Makers-Oakland-University/Makers-Unified-Controller/README.md

# Makers Unified Controller

The Makers at OU unified controller is a simple controller based on the ESP32 designed to be a one-size fits all controller for robotics projects and interactive exhibits. 
It is designed to be low cost, simple to assemble, and versatile to suit any project requirements. 
Programming and charging are accomplished by the available micro-usb plug, the battery can also be changed by the user. 

## Contents
This repo contains the EDA and CAD files for the controller created with [KiCad](https://www.kicad.org/) and [FreeCAD](https://www.freecadweb.org/) respectively. 
Both tools are open source and freely available 

## Contributing
For any new changes to the controller after version 1 please create a branch of pull request for any major design changes to the controller. 

## License
[MIT](https://choosealicense.com/licenses/mit/)
