Makers-Oakland-University/Makers-Unified-Controller/Controller Case/Makers-Unified-Controller-Rev1-Case.FCStd

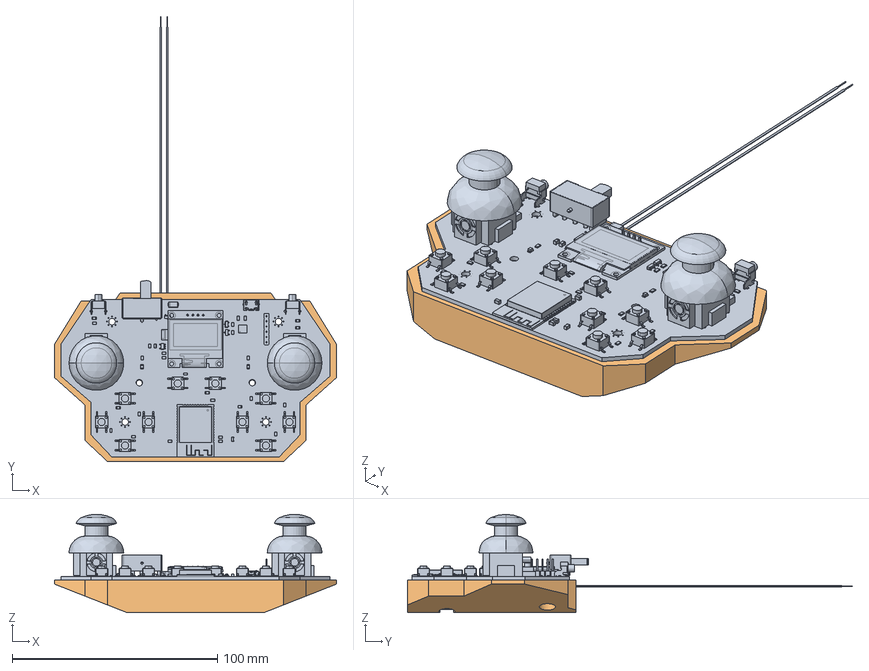
[picture p1: CAD file, 2021-12-16]
Controller Case/Makers-Unified-Controller-Rev1-Case.FCStd
137.4 x 216.7 x 47.9 mm
Makers-Unified-Controller
Bottom
