Makers-Oakland-University/Makers-Unified-Controller/Makers-Unified-Controller/Imports/PRT-18286.step

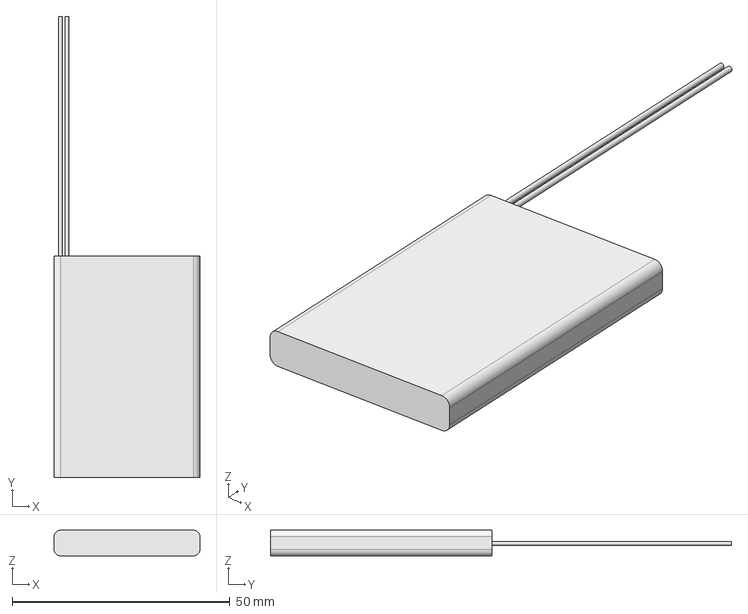
[picture p2: CAD file, 2022-06-18]
Makers-Unified-Controller/Imports/PRT-18286.step
33.5 x 105.8 x 5.90 mm
