Makers-Oakland-University/Makers-Unified-Controller/Makers-Unified-Controller/Imports/IND_NRS5024T4R7MMGJ_TAY.step

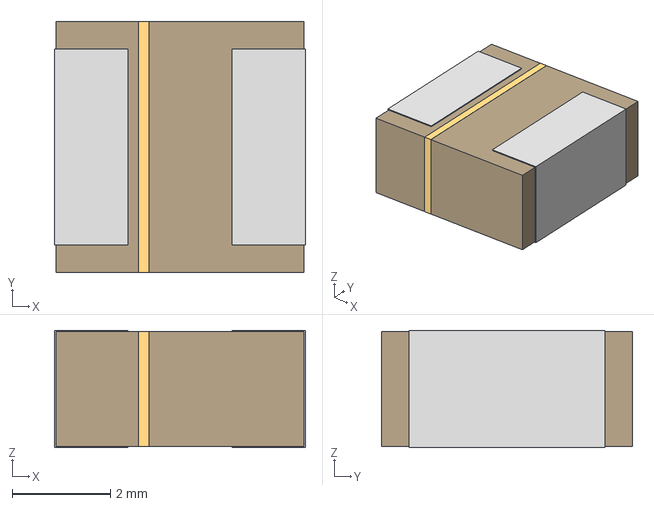
[picture p3: CAD file, 2021-12-05]
Makers-Unified-Controller/Imports/IND_NRS5024T4R7MMGJ_TAY.step
5.11 x 5.11 x 2.39 mm
