Makers-Oakland-University/Makers-Unified-Controller/Makers-Unified-Controller/Imports/c-1825027-8-g-3d.stp

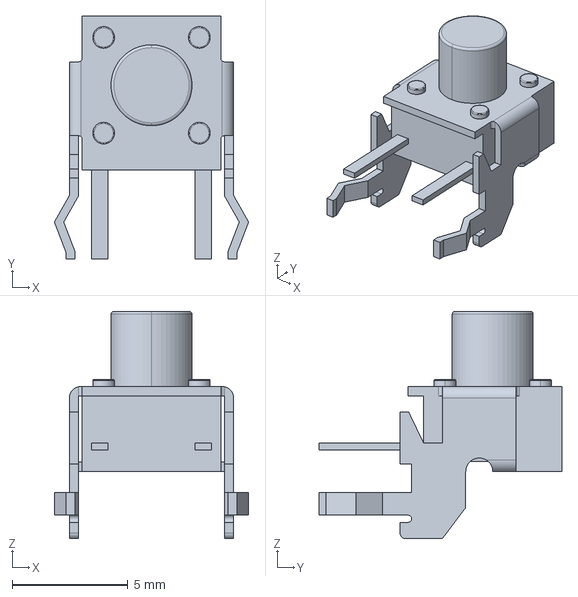
[picture p4: CAD file, 2021-12-05]
Makers-Unified-Controller/Imports/c-1825027-8-g-3d.stp
8.41 x 10.5 x 9.84 mm
