Makers-Oakland-University/Makers-Unified-Controller/Makers-Unified-Controller/Imports/USB4105--3DModel-STEP-56544.STEP

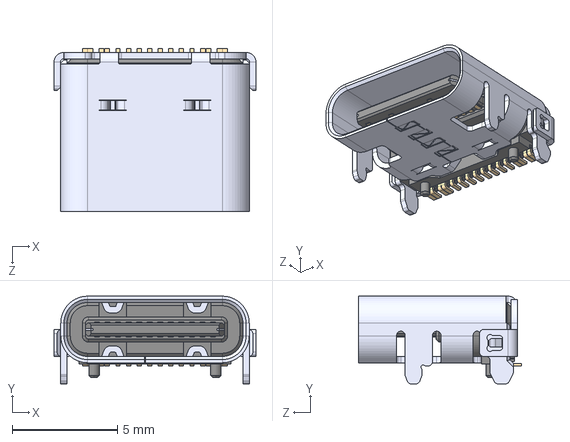
[picture p5: CAD file, 2021-12-05]
Makers-Unified-Controller/Imports/USB4105--3DModel-STEP-56544.STEP
9.58 x 4.16 x 7.71 mm
