Makers-Oakland-University/Makers-Unified-Controller/Makers-Unified-Controller/Imports/BC4AAW.step

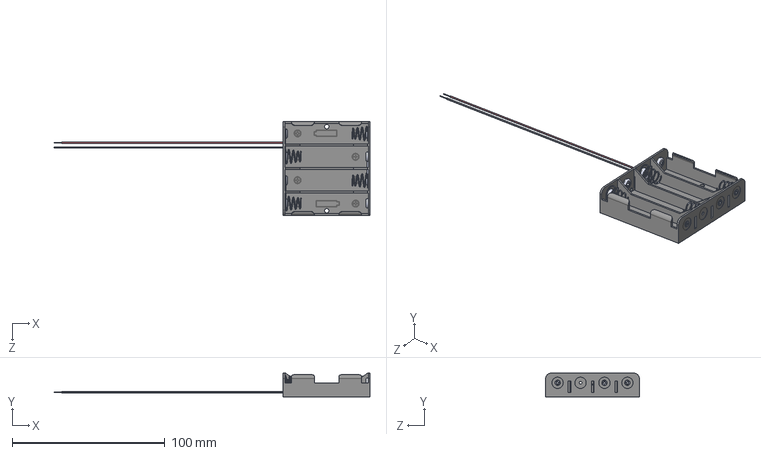
[picture p6: CAD file, 2021-12-05]
Makers-Unified-Controller/Imports/BC4AAW.step
206.8 x 15.5 x 61.3 mm
