Makers-Oakland-University/Makers-Unified-Controller/Makers-Unified-Controller/Imports/c-1571563-4-v-3d.stp

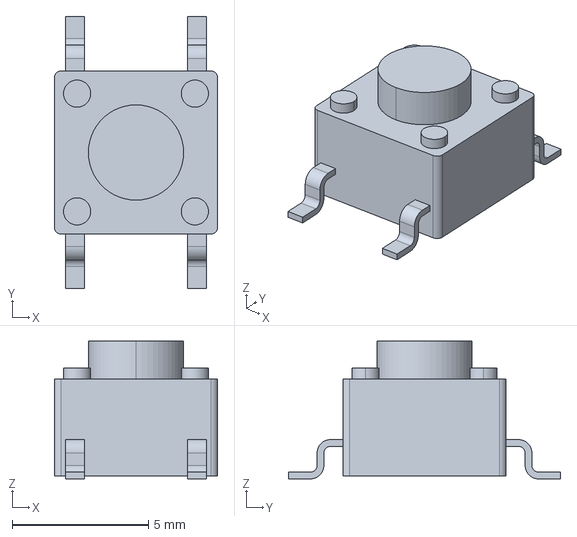
[picture p7: CAD file, 2021-12-05]
Makers-Unified-Controller/Imports/c-1571563-4-v-3d.stp
6.00 x 10.0 x 5.07 mm
