Makers-Oakland-University/Makers-Unified-Controller/Makers-Unified-Controller/Imports/SSD1306.STP

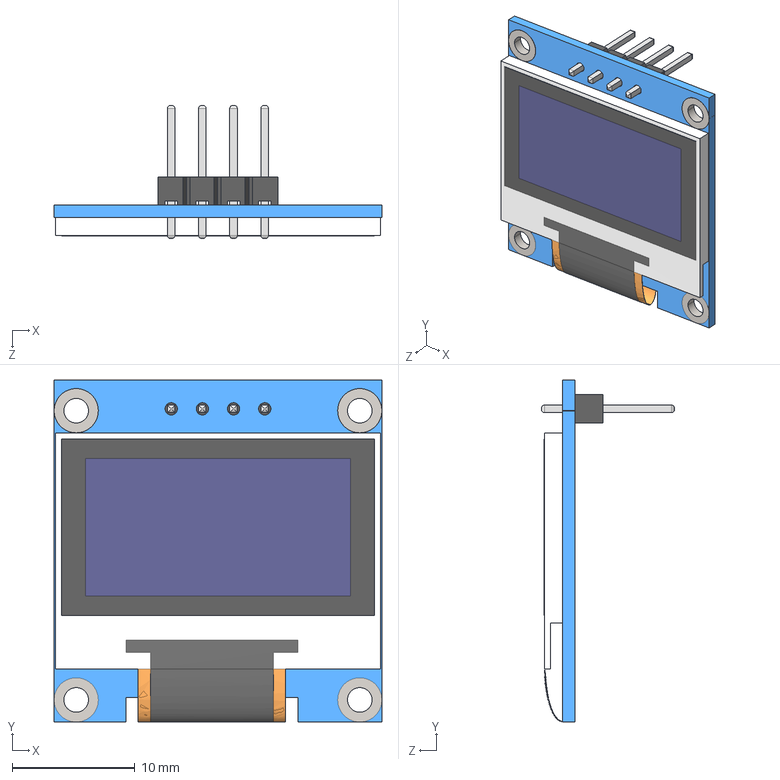
[picture p8: CAD file, 2021-12-05]
Makers-Unified-Controller/Imports/SSD1306.STP
26.7 x 27.9 x 10.8 mm
