Makers-Oakland-University/Makers-Unified-Controller/Makers-Unified-Controller/Imports/COM-09032.step

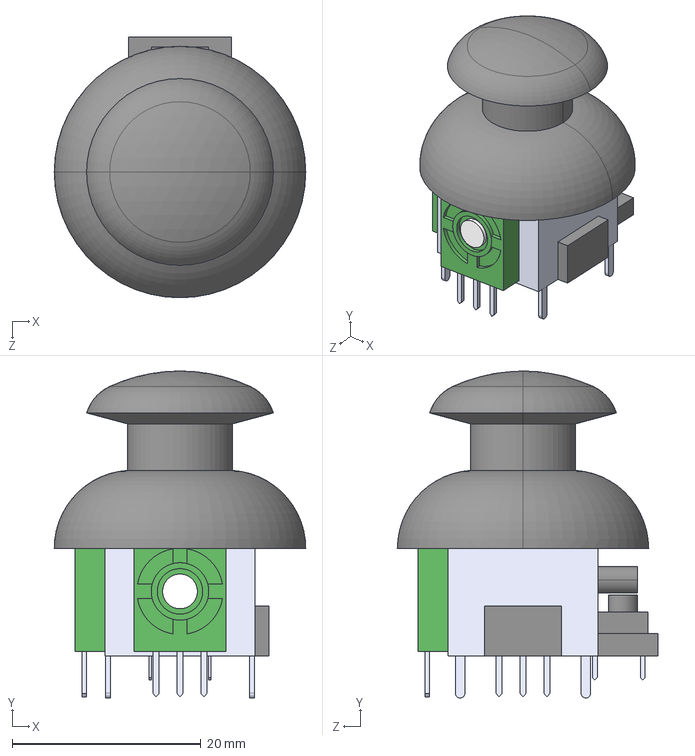
[picture p9: CAD file, 2021-12-05]
Makers-Unified-Controller/Imports/COM-09032.step
26.7 x 34.7 x 27.6 mm
