Makers-Oakland-University/Makers-Unified-Controller/Makers-Unified-Controller/Imports/10118192-0002LF.step

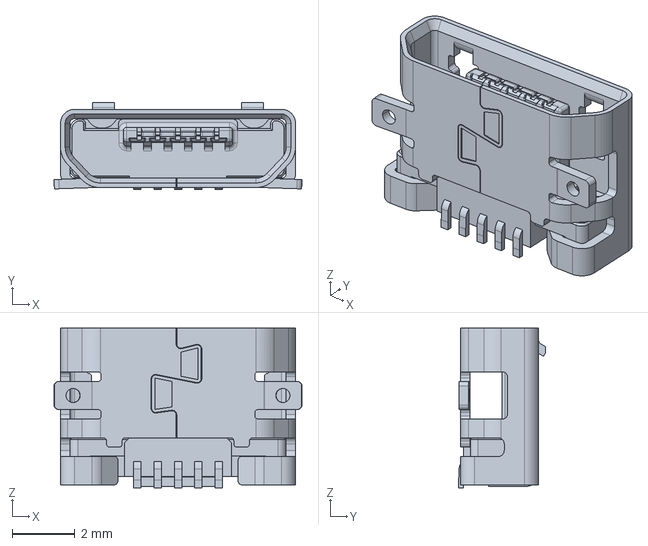
[picture p10: CAD file, 2021-12-05]
Makers-Unified-Controller/Imports/10118192-0002LF.step
7.91 x 2.77 x 5.10 mm
