Makers-Oakland-University/Makers-Unified-Controller/Makers-Unified-Controller/Imports/L102021ML04Q.step

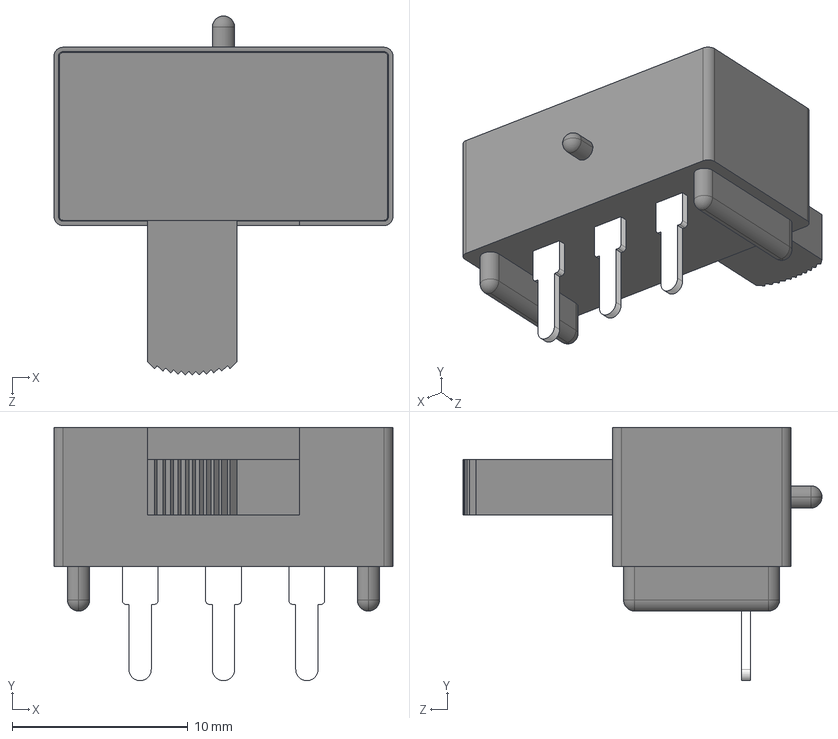
[picture p11: CAD file, 2021-12-05]
Makers-Unified-Controller/Imports/L102021ML04Q.step
19.3 x 14.4 x 20.4 mm
