Makers-Oakland-University/Makers-Unified-Controller/Makers-Unified-Controller/Makers-Unified-Controller.pdf

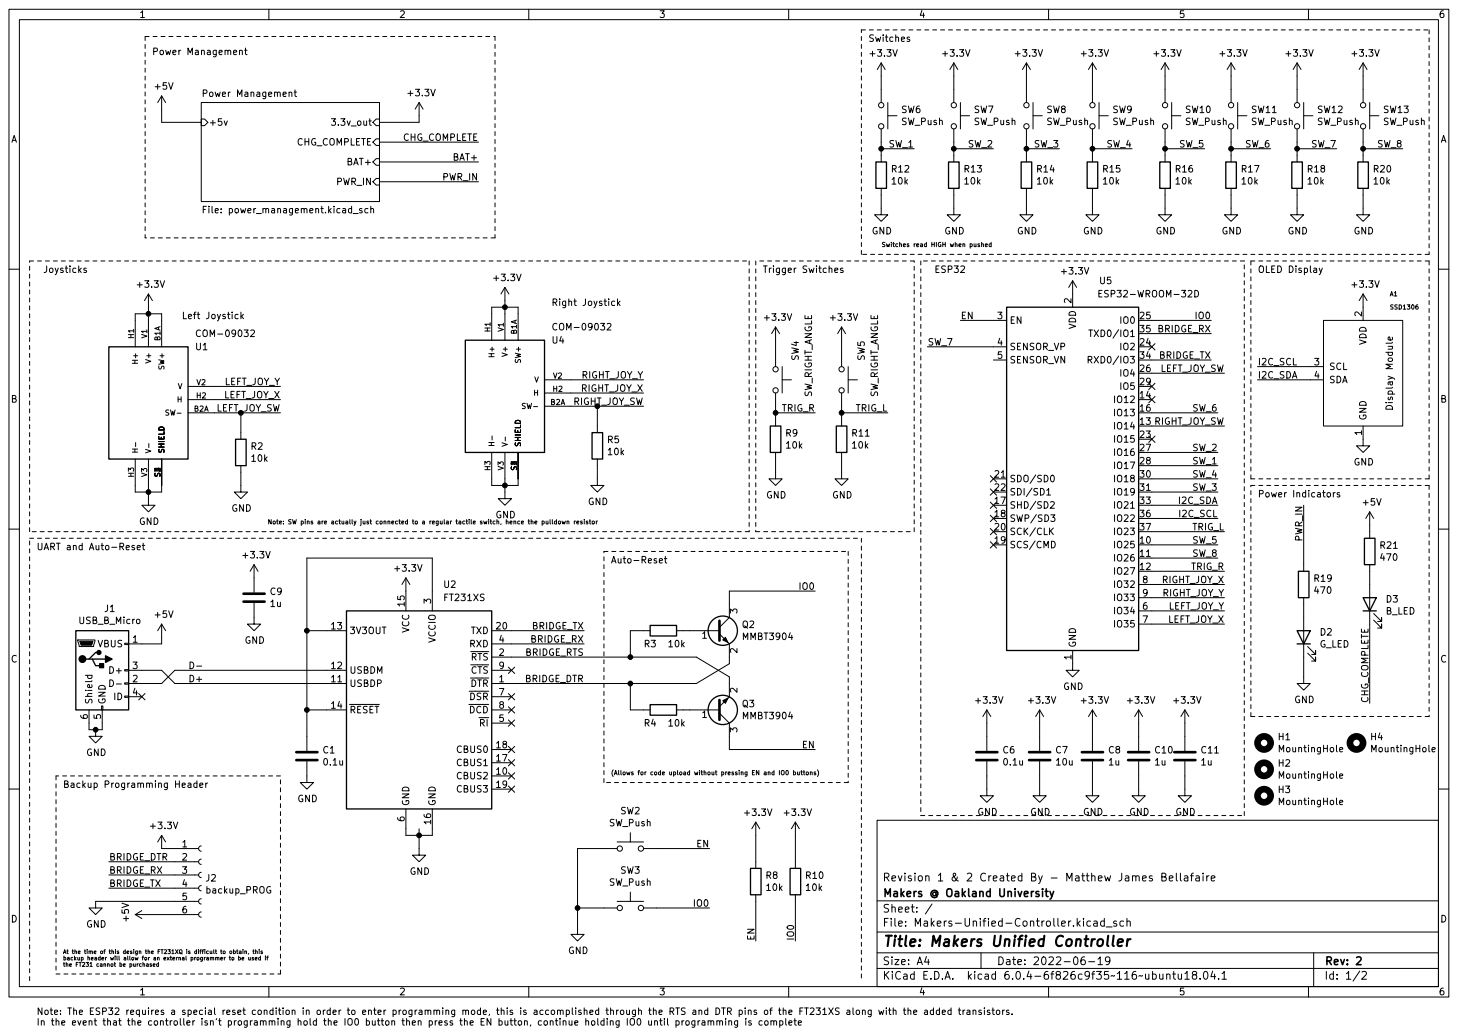
[picture p12: page 1]

OLED Display Power Indicators ESP32 Switches Auto-Reset Note: The ESP32 requires a special reset condition in order to enter programming mode, this is accomplished through the RTS and DTR pins of the FT231XS along with the added transistors.

Switches read HIGH when pushed Power Management

2 SCK/CLK 20 SDO/SD0 21 SDI/SD1 22

UART and Auto-Reset Backup Programming Header At the time of this design the FT231XQ is difficult to obtain, this backup header will allow for an external programmer to be used if

Revision 1 & 2 Created By - Matthew James Bellafaire
File: Makers-Unified-Controller.kicad_sch Sheet: / Makers @ Oakland University

Id: 1/2 Title: Makers Unified Controller

the FT231 cannot be purchased

In the event that the controller isn't programming hold the IO0 button then press the EN button, continue holding IO0 until programming is complete

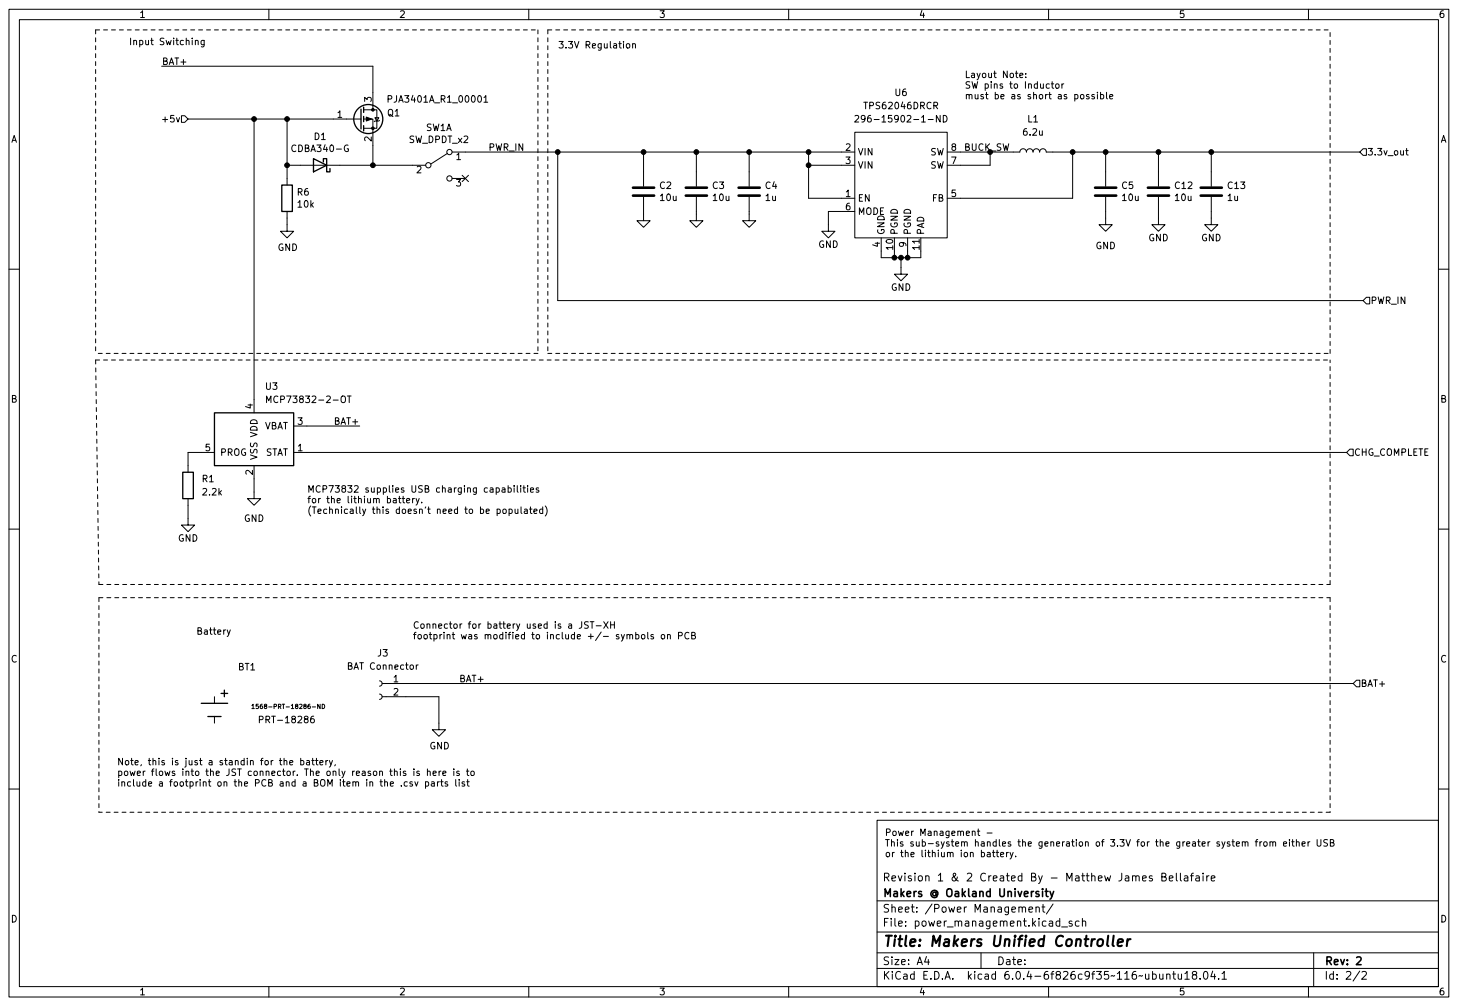
[picture p13: page 2]

Layout Note:
SW pins to Inductor
must be as short as possible

4 PROG 5 U3MCP73832-2-OT EN 1 PGND 10 PAD 11 VIN 2 VIN 3 GND

4 FB 5 MODE 6 SW 7 SW 8 PGND

MCP73832 supplies USB charging capabilities
for the lithium battery.
(Technically this doesn't need to be populated)

Connector for battery used is a JST-XH
footprint was modified to include +/- symbols on PCB

Note, this is just a standin for the battery,
power flows into the JST connector. The only reason this is here is to
include a footprint on the PCB and a BOM item in the .csv parts list

Power Management -
This sub-system handles the generation of 3.3V for the greater system from either USB
or the lithium ion battery.
Revision 1 & 2 Created By - Matthew James Bellafaire
Makers @ Oakland University
Sheet: /Power Management/
File: power_management.kicad_sch
Id: 2/2 Title: Makers Unified Controller
