Makers-Oakland-University/Makers-Unified-Controller/Makers-Unified-Controller/Makers-Unified-Controller.kicad_pcb

## KiCad design Makers-Unified-Controller/Makers-Unified-Controller.kicad_pcb (2022-07-20)

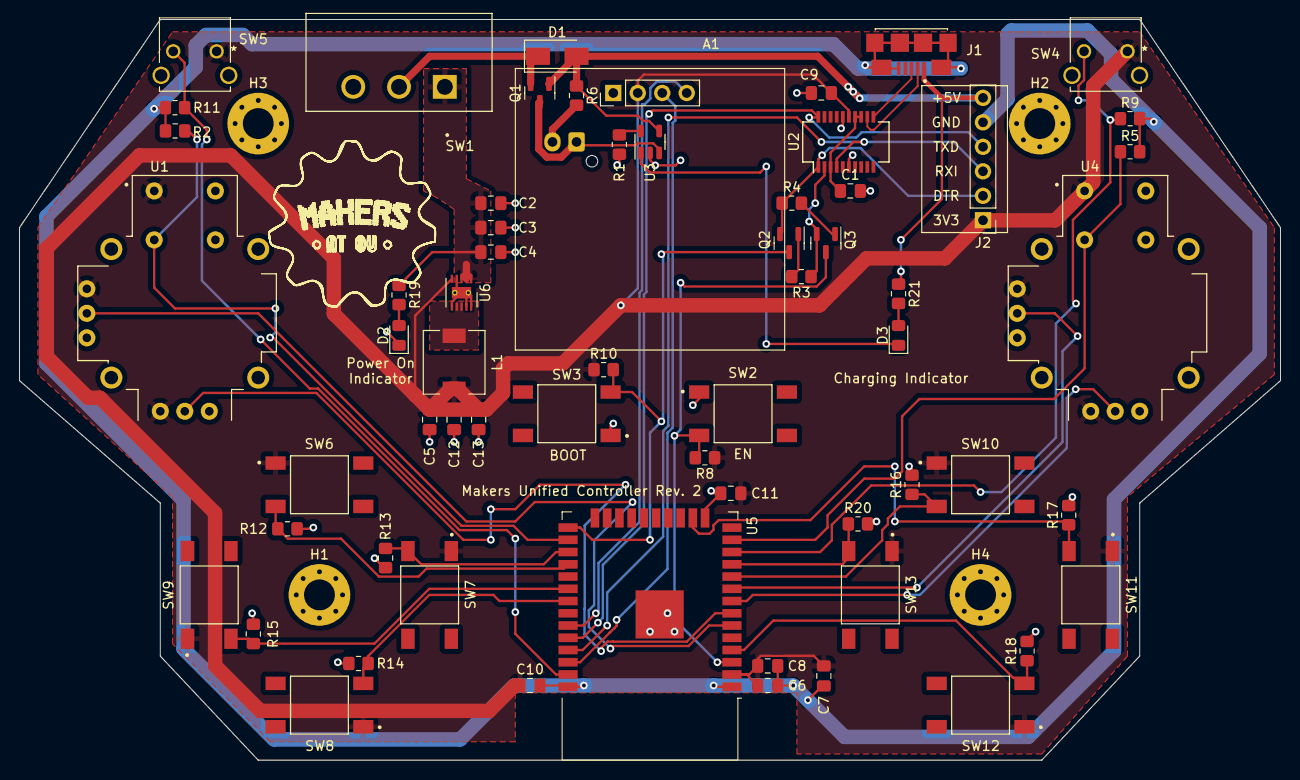
[picture p14: board Makers-Unified-Controller.kicad_pcb from above]

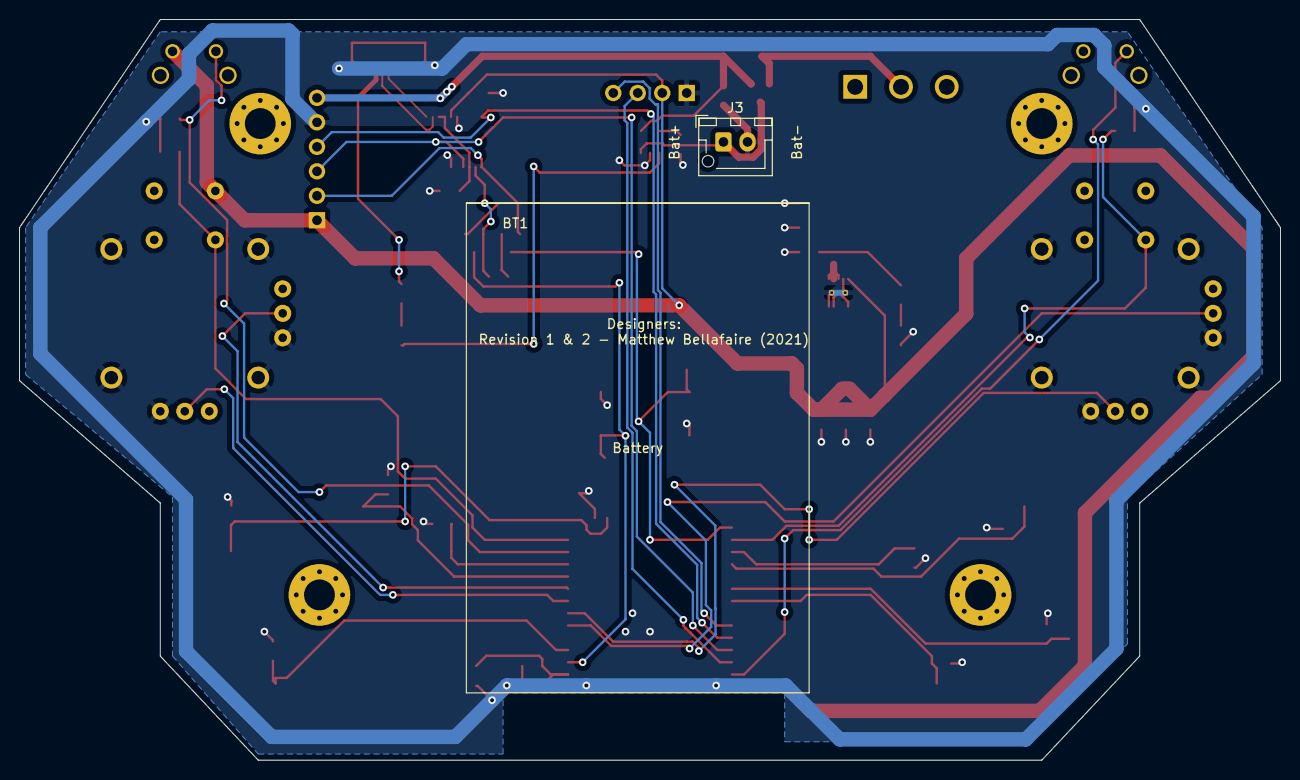
[picture p15: board Makers-Unified-Controller.kicad_pcb from below]

Board: 2 copper layers, 130.8 x 76.8 mm, 68 parts (2 on the bottom side), 40 nets.

Parts:
A1: SSD1306
BT1: PRT-18286; PRT18286
C1, C6: 0.1u; C_0805_2012Metric_Pad1.18x1.45mm_HandSolder
C2, C3, C5, C7, C12: 10u; C_0805_2012Metric_Pad1.18x1.45mm_HandSolder
C4, C8, C9, C10, C11, C13: 1u; C_0805_2012Metric_Pad1.18x1.45mm_HandSolder
D1: CDBA340-G; D_SMA
D2: G_LED; LED_0805_2012Metric_Pad1.15x1.40mm_HandSolder
D3: B_LED; LED_0805_2012Metric_Pad1.15x1.40mm_HandSolder
H1, H2, H3, H4: MountingHole; MountingHole_3.2mm_M3_Pad_Via
J1: USB_B_Micro; AMPHENOL_10118192-0002LF
J2: backup_PROG; backup_prog_header
J3: BAT Connector; PRT-18286 Connector
L1: 6.2u; L_6.3x6.3_H3
Q1: PJA3401A_R1_00001; SOT-23
Q2, Q3: MMBT3904; SOT-23
R1, R19, R21: 2.2k; R_0805_2012Metric_Pad1.20x1.40mm_HandSolder
R2, R3, R4, R5, R6, R8, R9, R10, R11, R12, R13, R14, R15, R16, R17, R18, R20: 10k; R_0805_2012Metric_Pad1.20x1.40mm_HandSolder
SW1: SW_DPDT_x2; SW_L102021ML04Q
SW2, SW3, SW6, SW7, SW8, SW9, SW10, SW11, SW12, SW13: SW_Push; SW_1571563-4
SW4, SW5: SW_RIGHT_ANGLE; 1825027-8
U1, U4: COM-09032; XDCR_COM-09032
U2: FT231XS; SSOP-20_3.9x8.7mm_P0.635mm
U3: MCP73832-2-0T; SOT-23-5
U5: ESP32-WROOM-32D; ESP32-WROOM-32
U6: TPS62046DRCR; VSON-10-1EP_3x3mm_P0.5mm_EP1.2x2mm_ThermalVias

Connections:
+3V3: A1.2 (VDD), C5.1, C6.1, C7.1, C8.1, C9.1, C10.1, C11.1, C12.1, C13.1, J2.1, L1.2, R8.1, R10.1, SW4.1, SW5.1, SW6.1, SW7.1, SW8.1, SW9.1, SW10.1, SW11.1, SW12.1, SW13.1, U1.B1A (SW+), U1.H1 (H+), U1.V1 (V+), U2.15 (VCC), U4.B1A (SW+), U4.H1 (H+), U4.V1 (V+), U5.2 (VDD), U6.5 (FB)
+5V: D1.2 (A), J1.1 (VBUS), J2.6, Q1.1 (G), R6.1, R21.1, U3.4 (VDD)
/BAT+: J3.1, Q1.3 (D), U3.3 (VBAT)
/BRIDGE_DTR: J2.2, Q2.2 (E), R4.1, U2.1 (~DTR)
/BRIDGE_RTS: Q3.2 (E), R3.1, U2.2 (~RTS)
/BRIDGE_RX: J2.3, U2.4 (RXD), U5.35 (TXD0/IO1)
/BRIDGE_TX: J2.4, U2.20 (TXD), U5.34 (RXD0/IO3)
/CHG_COMPLETE: D3.1 (K), U3.1 (STAT)
/D+: J1.3 (D+), U2.11 (USBDP)
/D-: J1.2 (D-), U2.12 (USBDM)
/EN: Q3.3 (C), R8.2, SW2.3, U5.3 (EN)
/I2C_SCL: A1.3 (SCL), U5.36 (IO22)
/I2C_SDA: A1.4 (SDA), U5.33 (IO21)
/IO0: Q2.3 (C), R10.2, SW3.3, U5.25 (IO0)
/LEFT_JOY_SW: R2.1, U1.B2A (SW-), U5.26 (IO4)
/LEFT_JOY_X: U1.H2 (H), U5.7 (IO35)
/LEFT_JOY_Y: U1.V2 (V), U5.6 (IO34)
/PWR_IN: C2.1, C3.1, C4.1, R19.1, SW1.1 (A), U6.1 (EN), U6.2 (VIN), U6.3 (VIN)
/Power Management/BUCK_SW: L1.1, U6.7 (SW), U6.8 (SW)
/RIGHT_JOY_SW: R5.1, U4.B2A (SW-), U5.13 (IO14)
/RIGHT_JOY_X: U4.H2 (H), U5.8 (IO32)
/RIGHT_JOY_Y: U4.V2 (V), U5.9 (IO33)
/SW_1: R12.1, SW6.3, U5.28 (IO17)
/SW_2: R13.1, SW7.3, U5.27 (IO16)
/SW_3: R14.1, SW8.3, U5.31 (IO19)
/SW_4: R15.1, SW9.3, U5.30 (IO18)
/SW_5: R16.1, SW10.3, U5.10 (IO25)
/SW_6: R17.1, SW11.3, U5.16 (IO13)
/SW_7: R18.1, SW12.3, U5.4 (SENSOR_VP)
/SW_8: R20.1, SW13.3, U5.11 (IO26)
/TRIG_L: R11.1, SW5.2, U5.37 (IO23)
/TRIG_R: R9.1, SW4.2, U5.12 (IO27)
GND: A1.1 (GND), C1.2, C2.2, C3.2, C4.2, C5.2, C6.2, C7.2, C8.2, C9.2, C10.2, C11.2, C12.2, C13.2, D2.1 (K), J1.5 (GND), J1.6 (Shield), J2.5, J3.2, R1.2, R2.2, R5.2, R6.2, R9.2, R11.2, R12.2, R13.2, R14.2, R15.2, R16.2, R17.2, R18.2, R20.2, SW2.1, SW3.1, U1.H3 (H-), U1.S1 (SHIELD), U1.S2 (SHIELD), U1.S3 (SHIELD), U1.S4 (SHIELD), U1.V3 (V-), U2.6 (GND), U2.16 (GND), U3.2 (VSS), U4.H3 (H-), U4.S1 (SHIELD), U4.S2 (SHIELD), U4.S3 (SHIELD), U4.S4 (SHIELD), U4.V3 (V-), U5.1 (GND), U5.15 (GND), U5.38 (GND), U5.39 (GND), U6.4 (GND), U6.6 (MODE), U6.9 (PGND), U6.10 (PGND), U6.11 (PAD)
unnamed: C1.1, U2.3 (VCCIO), U2.13 (3V3OUT), U2.14 (~RESET)
unnamed: D1.1 (K), Q1.2 (S), SW1.2 (B)
unnamed: D2.2 (A), R19.2
unnamed: D3.2 (A), R21.2
unnamed: Q2.1 (B), R3.2
unnamed: Q3.1 (B), R4.2
unnamed: R1.1, U3.5 (PROG)
