Makers-Oakland-University/Makers-Unified-Controller/(commit log)

2021-12-05 Initial Kicad Design - needs parts sources, footprints, and layout
    [COM-09032.step, Makers-Unified-Controller.kicad_pcb, Makers-Unified-Controller.sch]
2021-12-05 Completed schematic
    [10118192-0002LF.step, BC4AAW.step, IND_NRS5024T4R7MMGJ_TAY.step, L102021ML04Q.step, Makers-Unified-Controller.sch, SSD1306.STP, USB4105--3DModel-STEP-56544.STEP, c-1571563-4-v-3d.stp]
2021-12-05 Rough Component layout
    [Makers-Unified-Controller.sch]
2021-12-05 Compacted layout
    [Makers-Unified-Controller.kicad_pcb]
2021-12-06 Routed critical signals and power
    [Makers-Unified-Controller.kicad_pcb, Makers-Unified-Controller.sch]
2021-12-06 buck converter routing
    [Makers-Unified-Controller.kicad_pcb]
2021-12-07 Completed Routing
    [Makers-Unified-Controller.kicad_pcb, Makers-Unified-Controller.sch]
2021-12-07 Exported production files for rev 1 to "Revision 1 Production Files"
    [BOM.csv, JLC_assembly_bom.csv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]
2021-12-16 started cad work for controller
    [Makers-Unified-Controller-Rev1-Case.FCStd]
2021-12-17 created test script for the controller to validate assembly.
2022-04-01 TODO for revision 2 notes
    [Makers-Unified-Controller.sch]
2022-06-18 Completed Update of Schematic to Revision 2
    [Makers-Unified-Controller.kicad_sch, PRT-18286.step, power_management.kicad_sch]
2022-06-18 Started PCB - removed unused components from revision 1
    [Makers-Unified-Controller.kicad_pcb, Makers-Unified-Controller.kicad_sch, power_management.kicad_sch]
2022-06-18 fixed BOM item in schematic
    [Makers-Unified-Controller.kicad_sch, power_management.kicad_sch]
2022-06-19 Completed routing - TODO final checks
    [Makers-Unified-Controller.kicad_pcb, Makers-Unified-Controller.kicad_sch, power_management.kicad_sch]
2022-06-21 Finalized layout and exported files
    [BOM.csv, JLC_assembly_bom.csv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]
2022-06-21 minor edits
    [Makers-Unified-Controller.csv, Makers-Unified-Controller.kicad_sch, power_management.kicad_sch]
2022-07-13 added interactive BOM
2022-07-20 minor edits to schematic and Ibom
    [Makers-Unified-Controller.csv, Makers-Unified-Controller.kicad_pcb, Makers-Unified-Controller.kicad_sch, power_management.kicad_sch]
